antmicro/thunderbolt-gpu-adapter/assets/previews/layer5.png

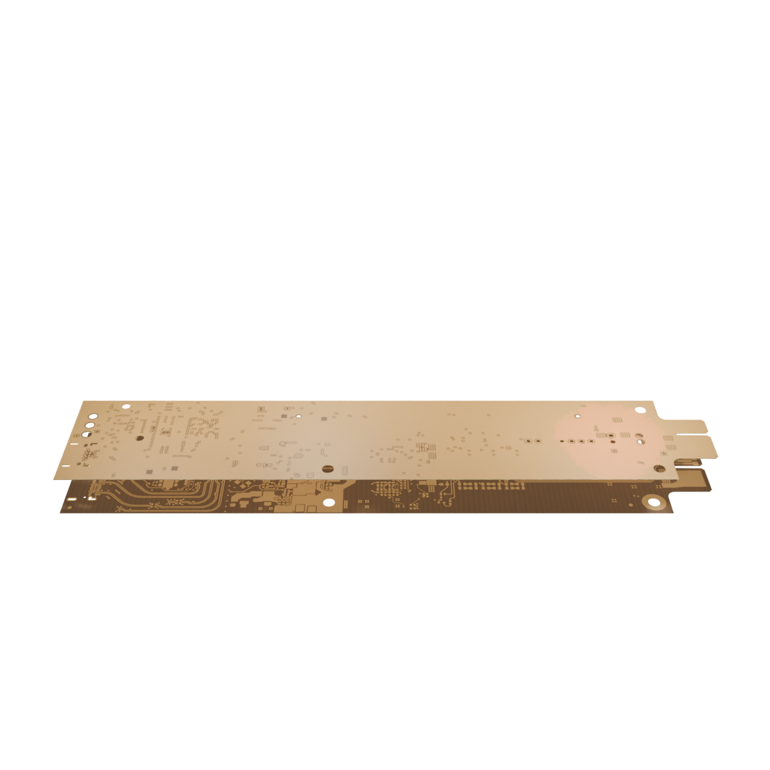
assets/previews/layer5.png
