antmicro/thunderbolt-gpu-adapter/assets/previews/leftB.png

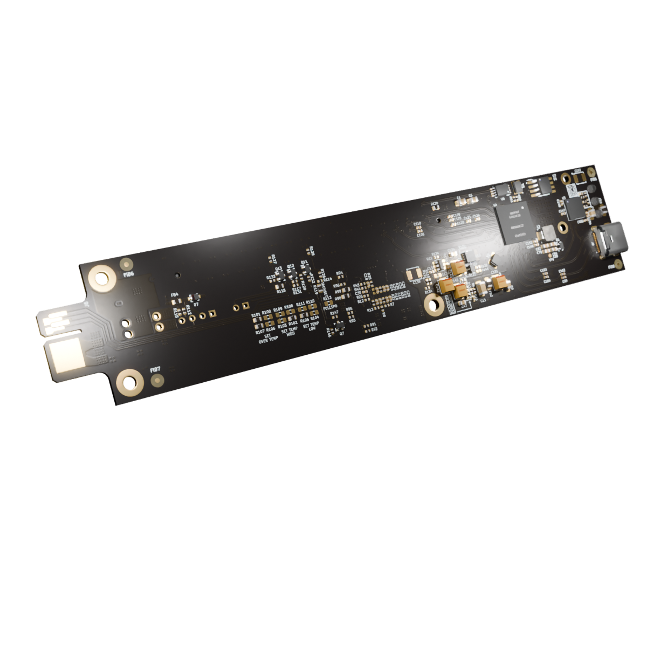
assets/previews/leftB.png
