antmicro/thunderbolt-gpu-adapter/assets/previews/leftT.png

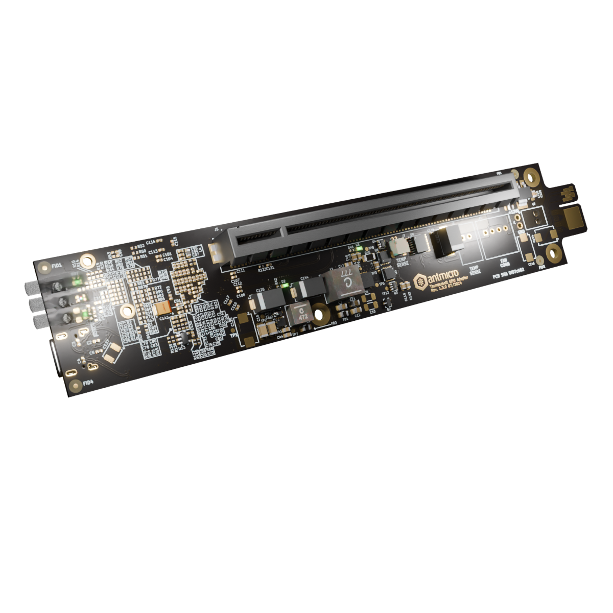
assets/previews/leftT.png
