antmicro/thunderbolt-gpu-adapter/assets/previews/orthoB.png

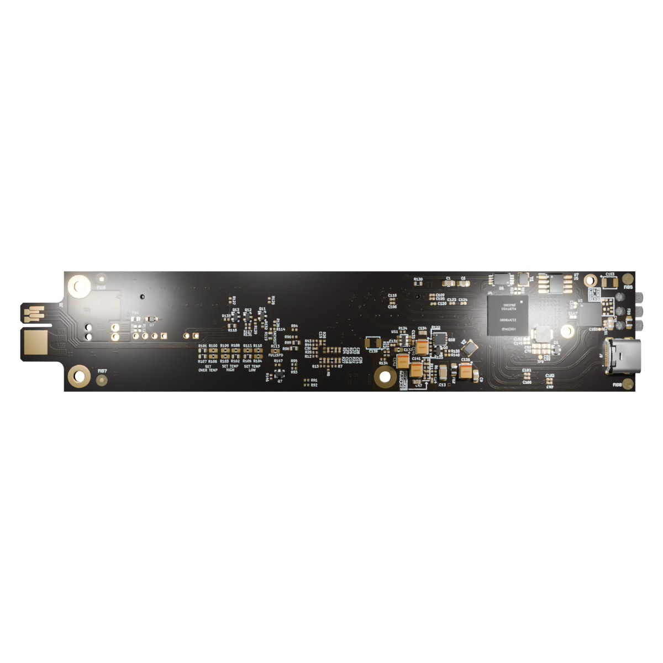
assets/previews/orthoB.png
