antmicro/thunderbolt-gpu-adapter/assets/previews/photoB.png

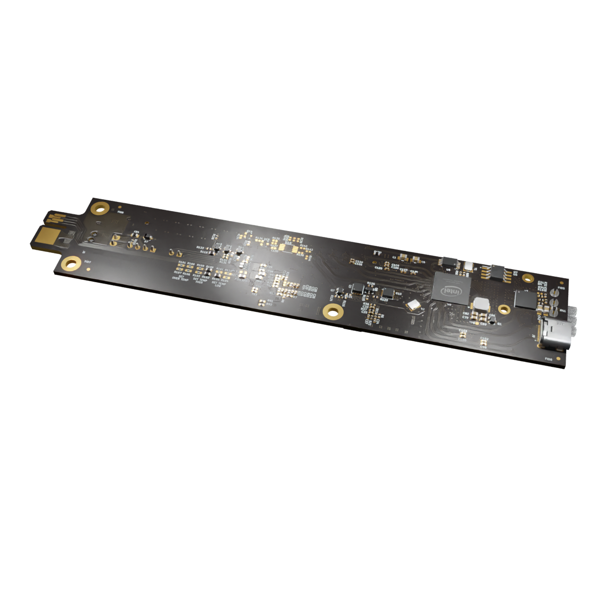
assets/previews/photoB.png
