antmicro/thunderbolt-gpu-adapter/assets/previews/rightB.png

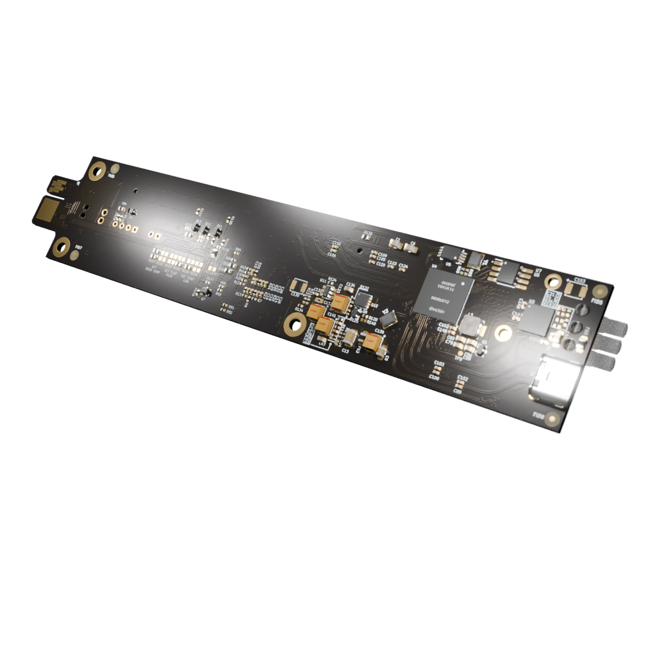
assets/previews/rightB.png
