antmicro/thunderbolt-gpu-adapter/doc/thunderbolt-gpu-adapter.pdf

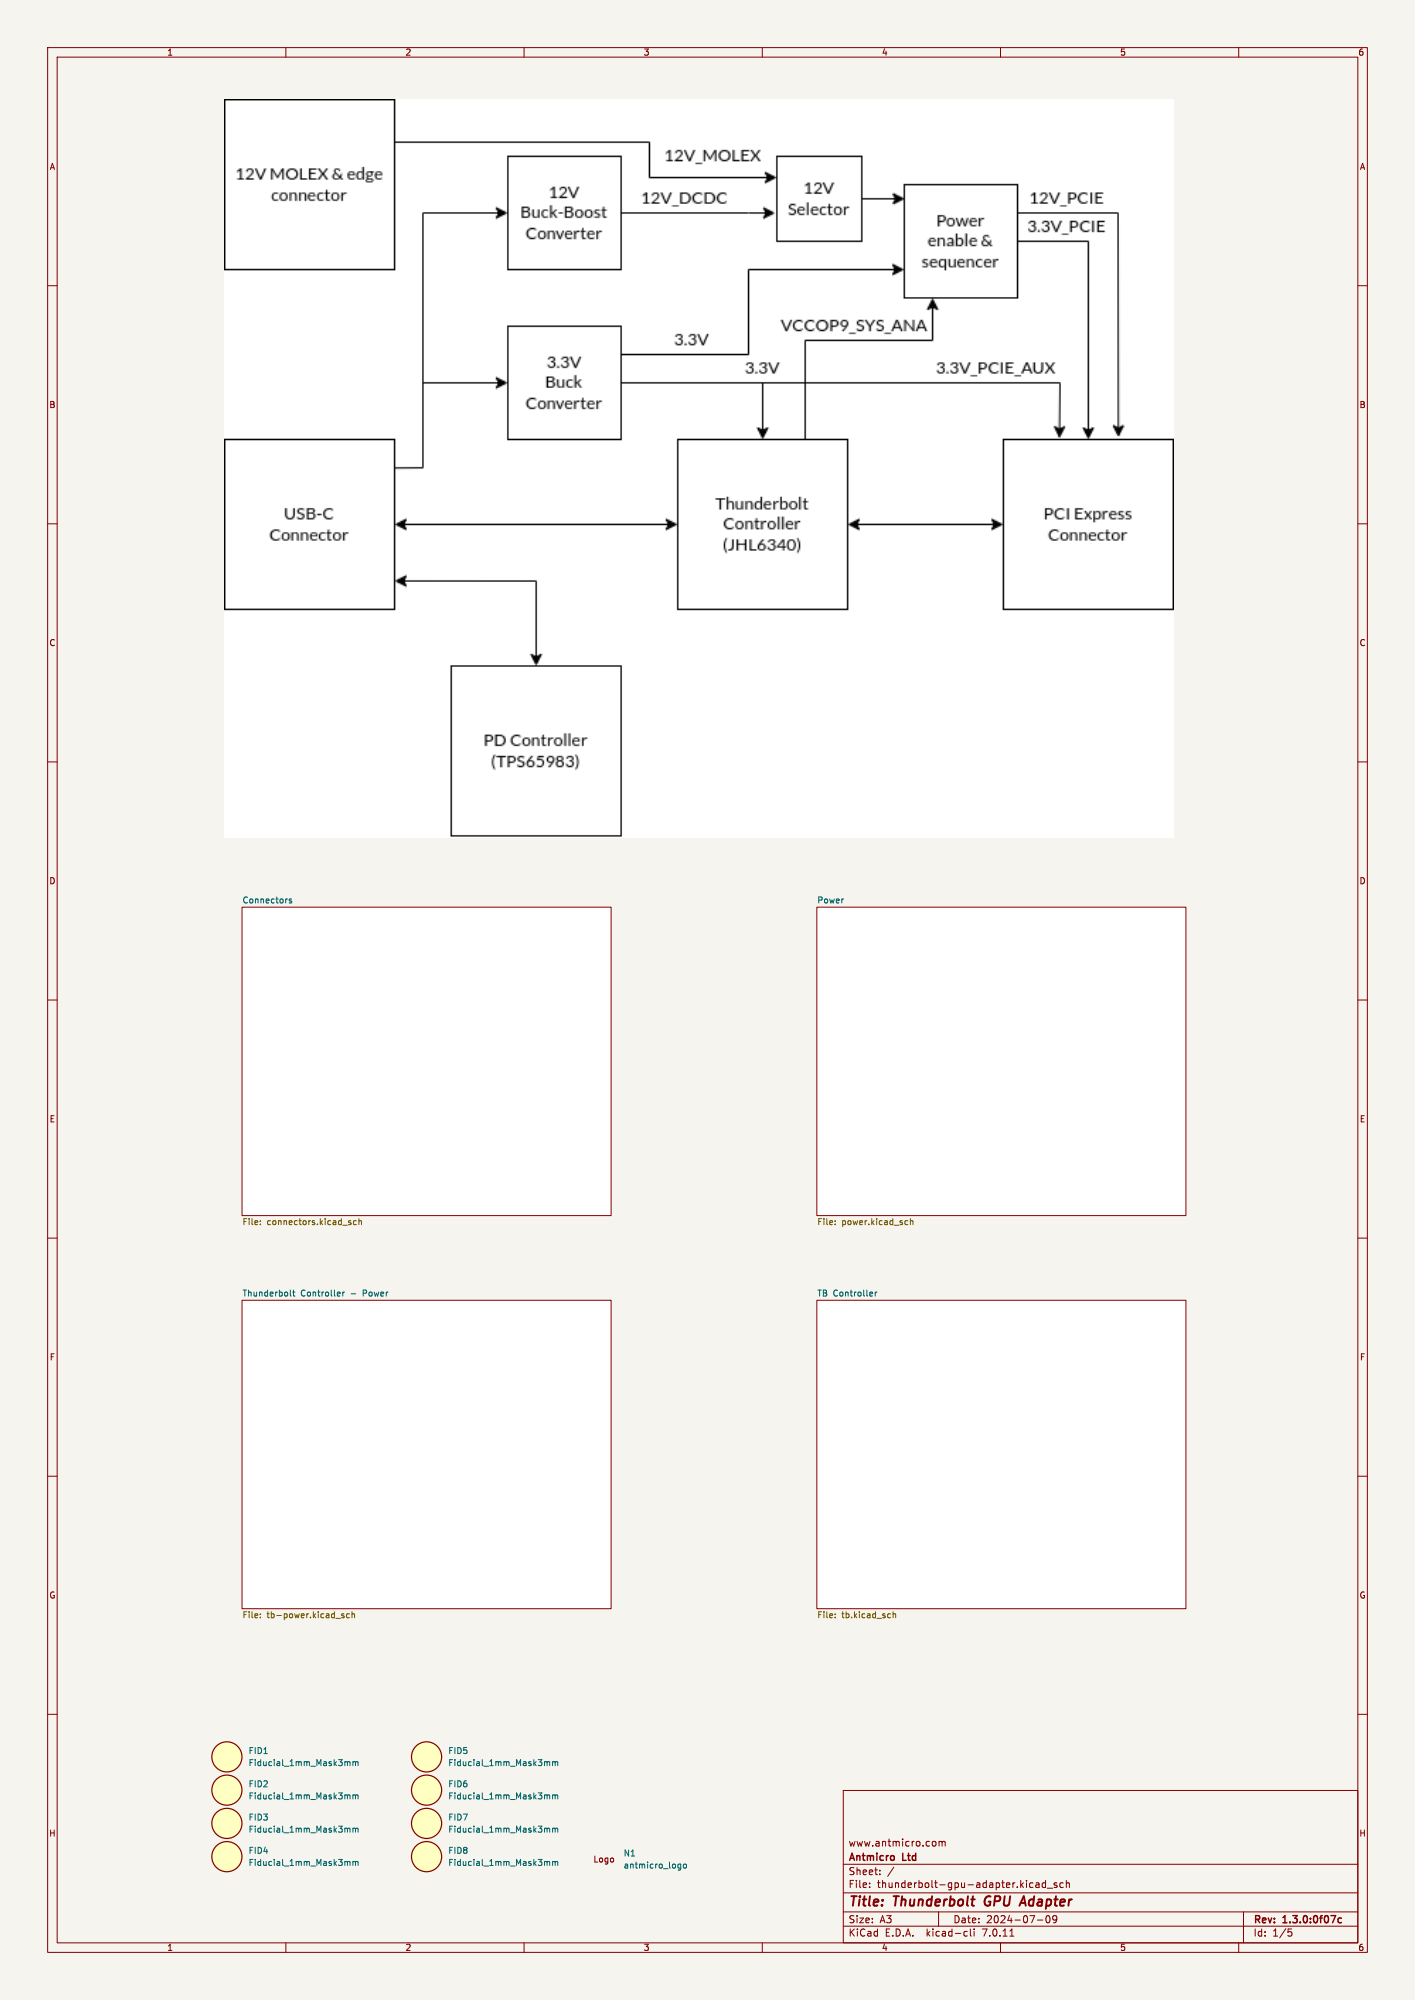
[picture p10: page 1]

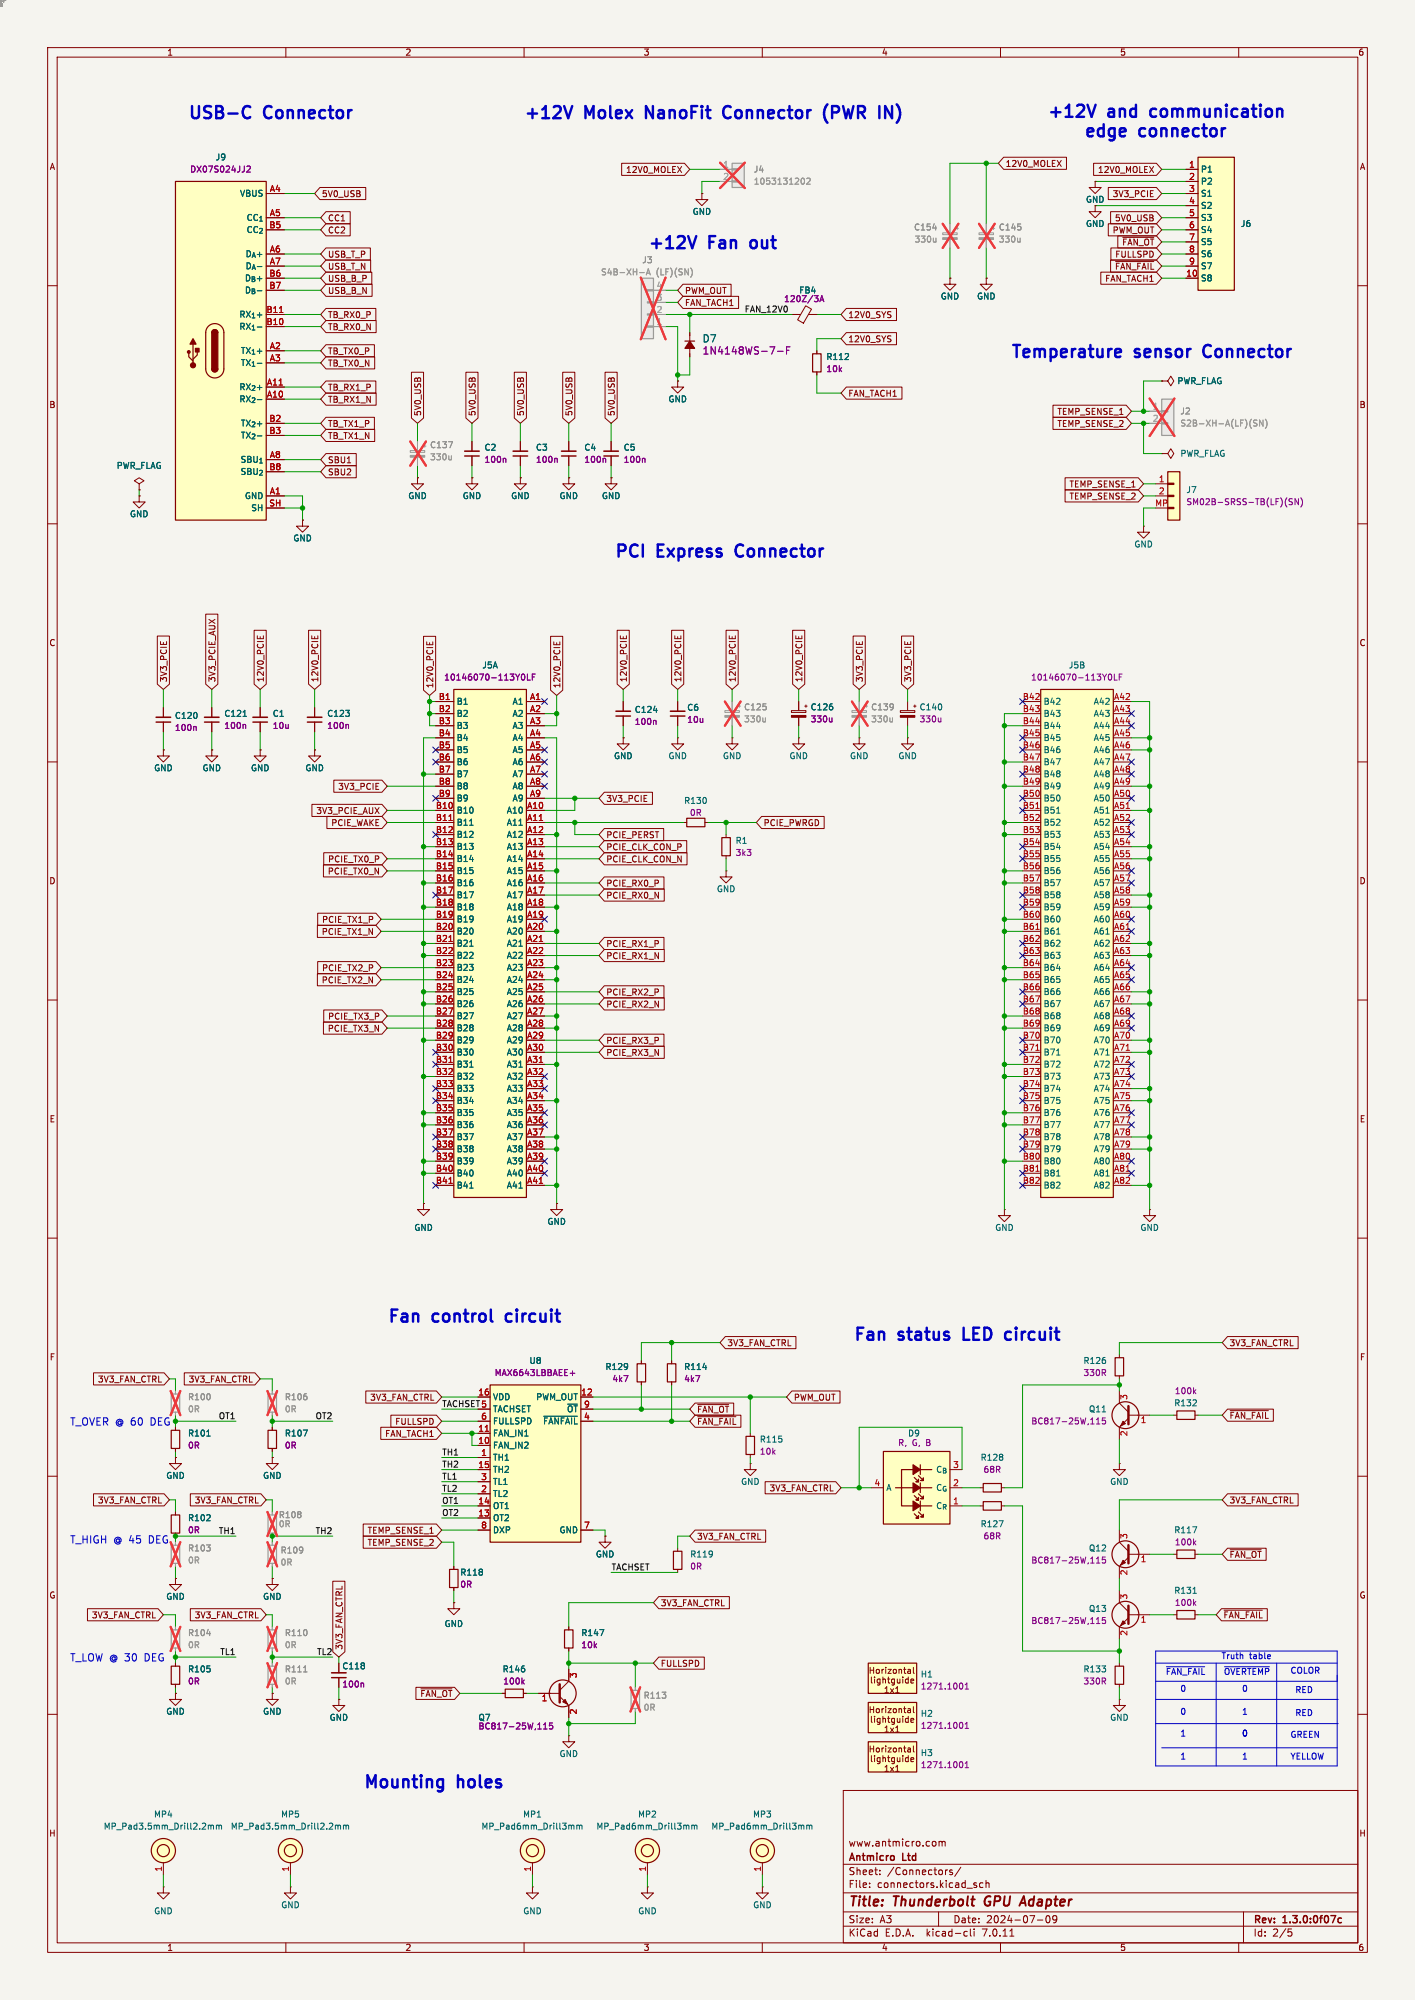
[picture p11: page 2]

+12V Molex NanoFit Connector (PWR IN)

J7SM02B-SRSS-TB(LF)(SN)

Truth table Fan status LED circuit

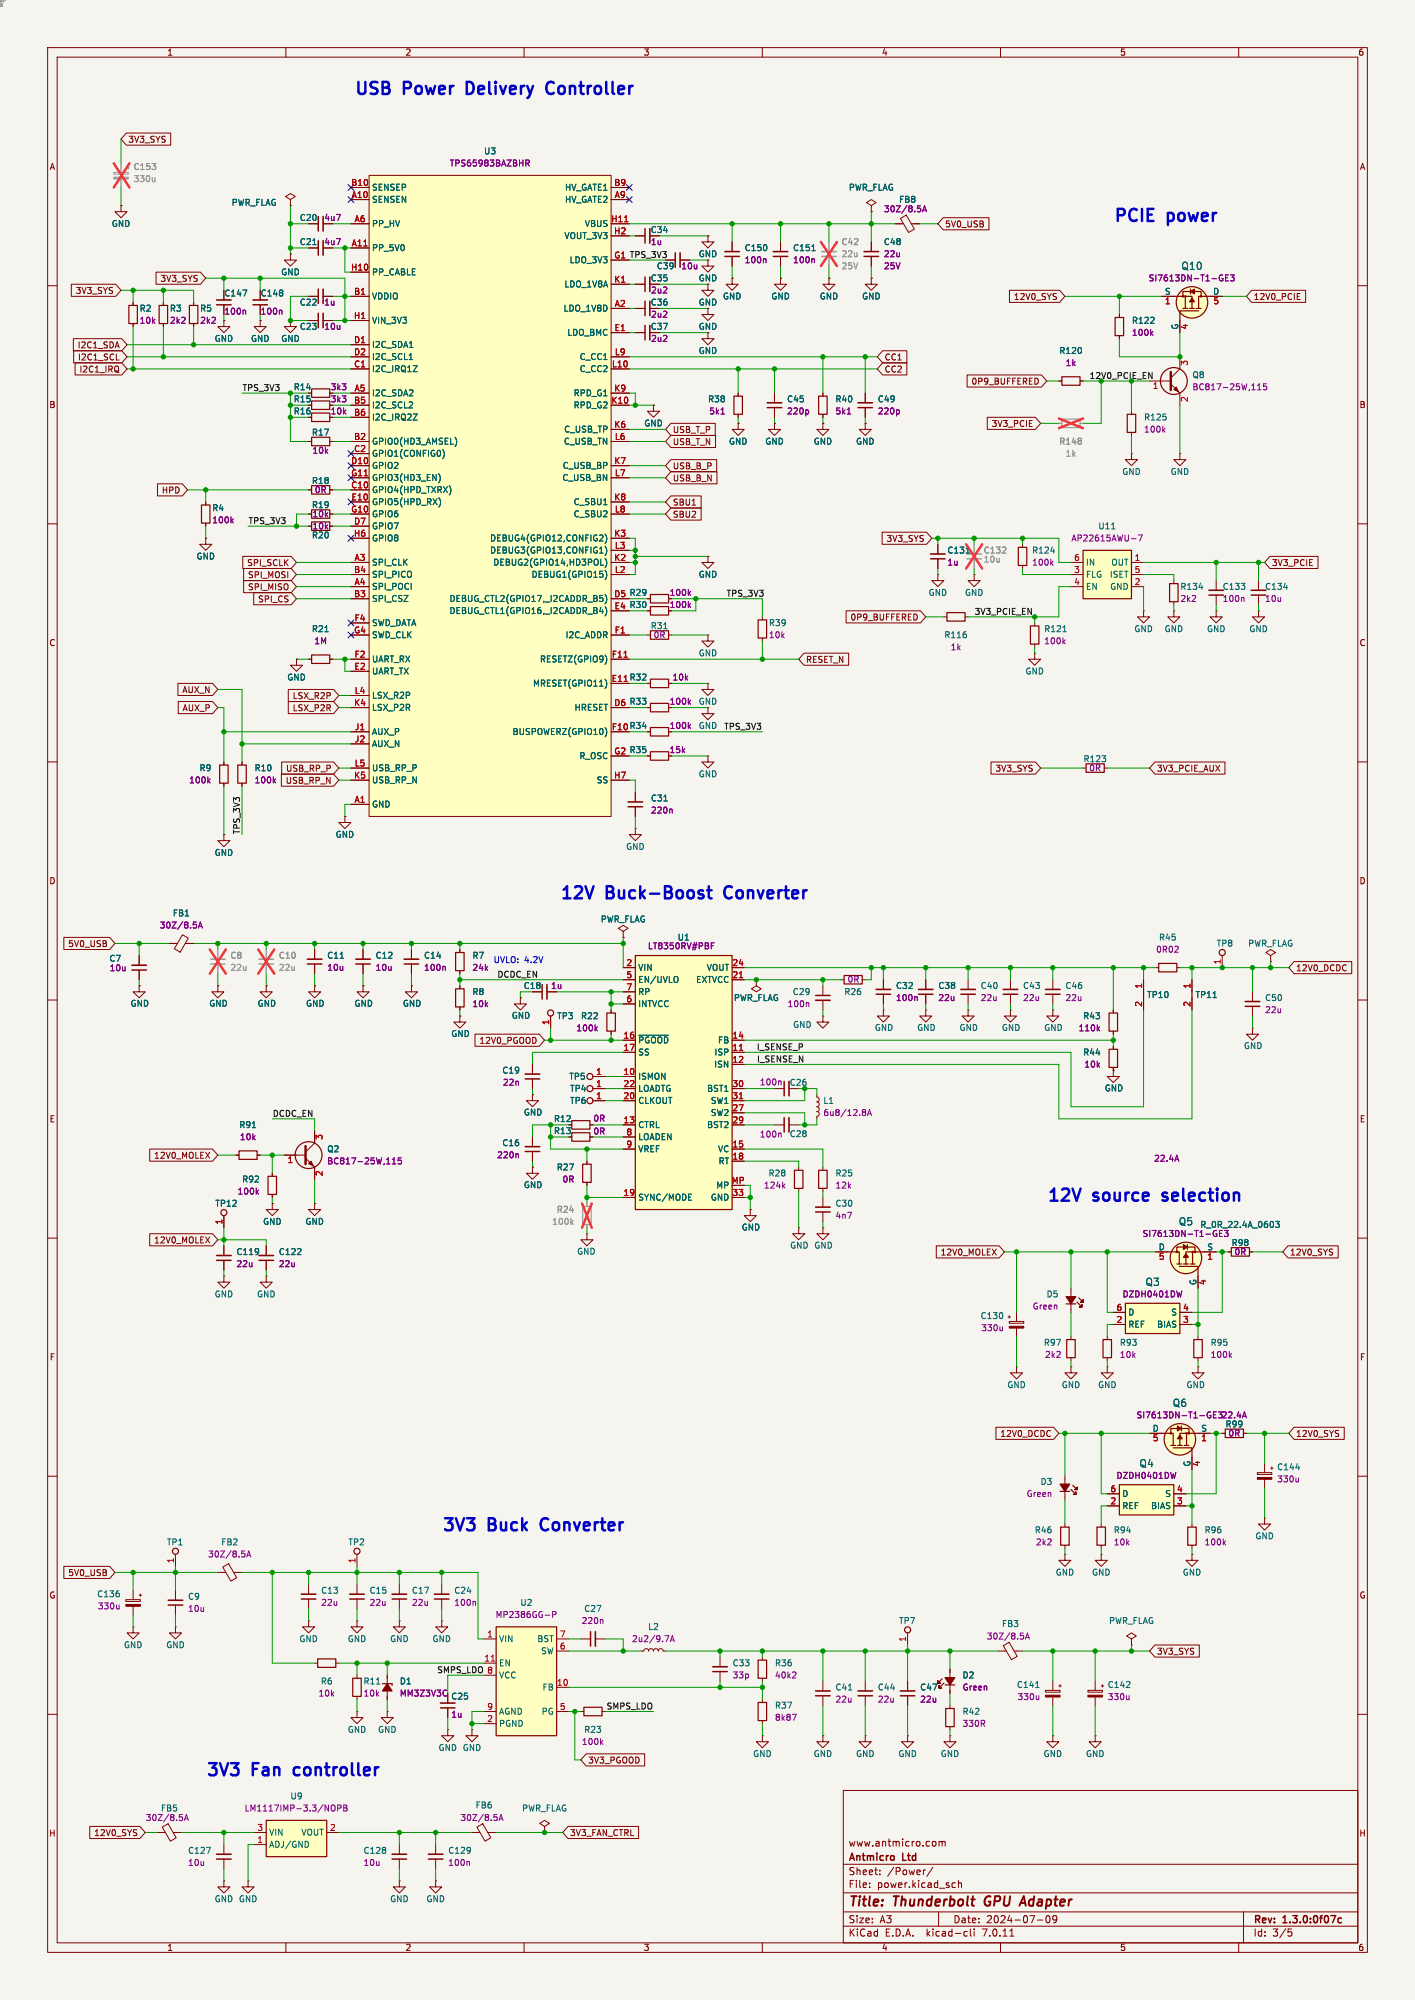
[picture p12: page 3]

USB Power Delivery Controller

OUT 1 GND 2 FLG 3 EN 4

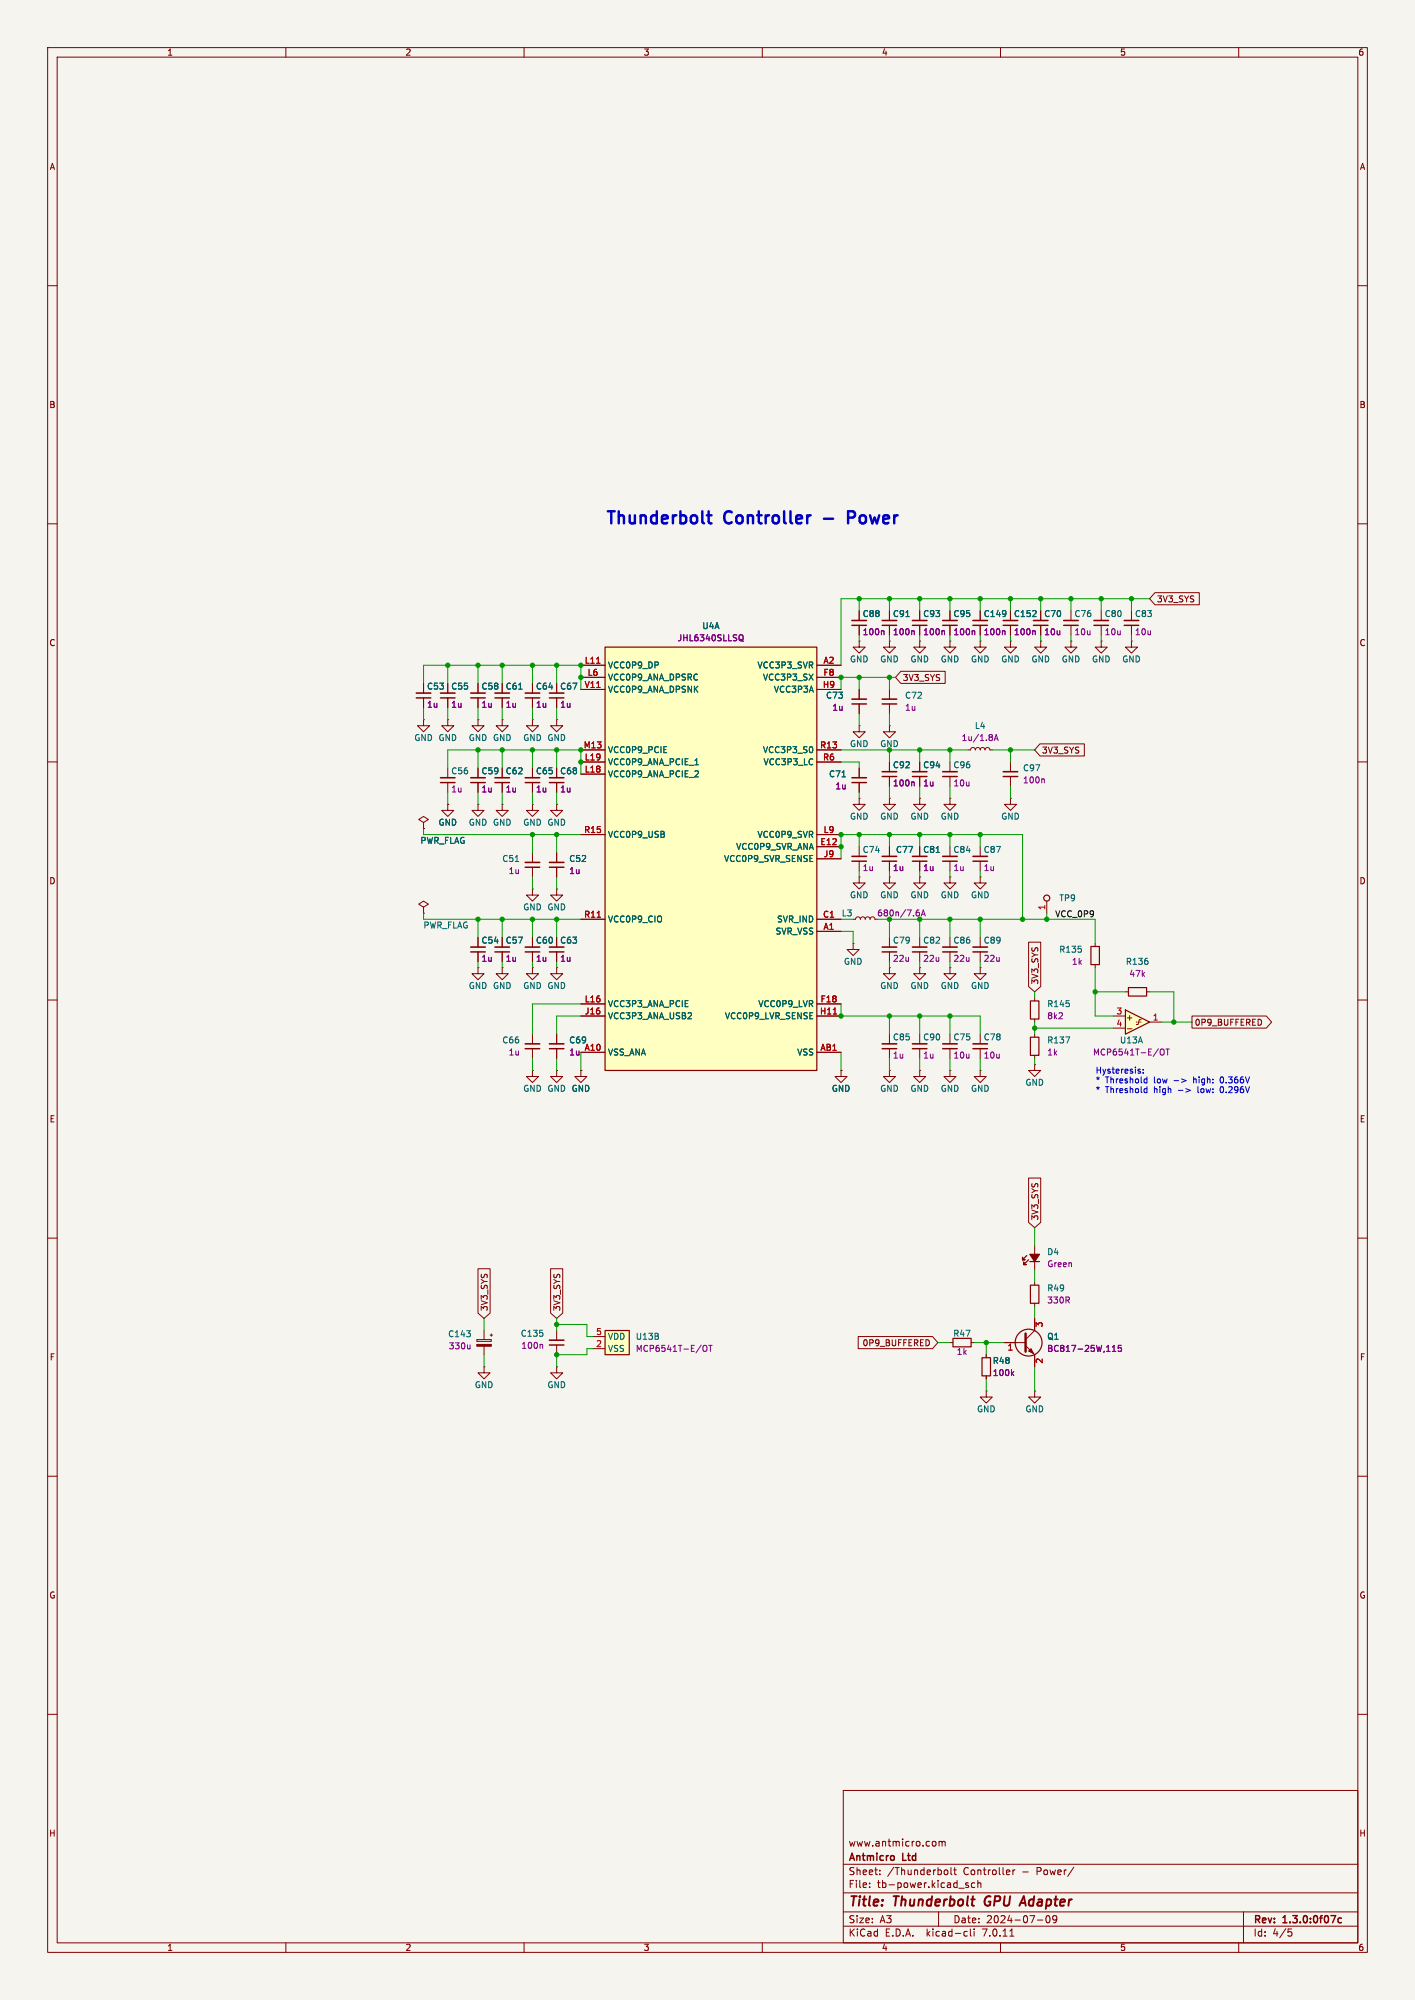
[picture p13: page 4]

1u GND GND GND GND

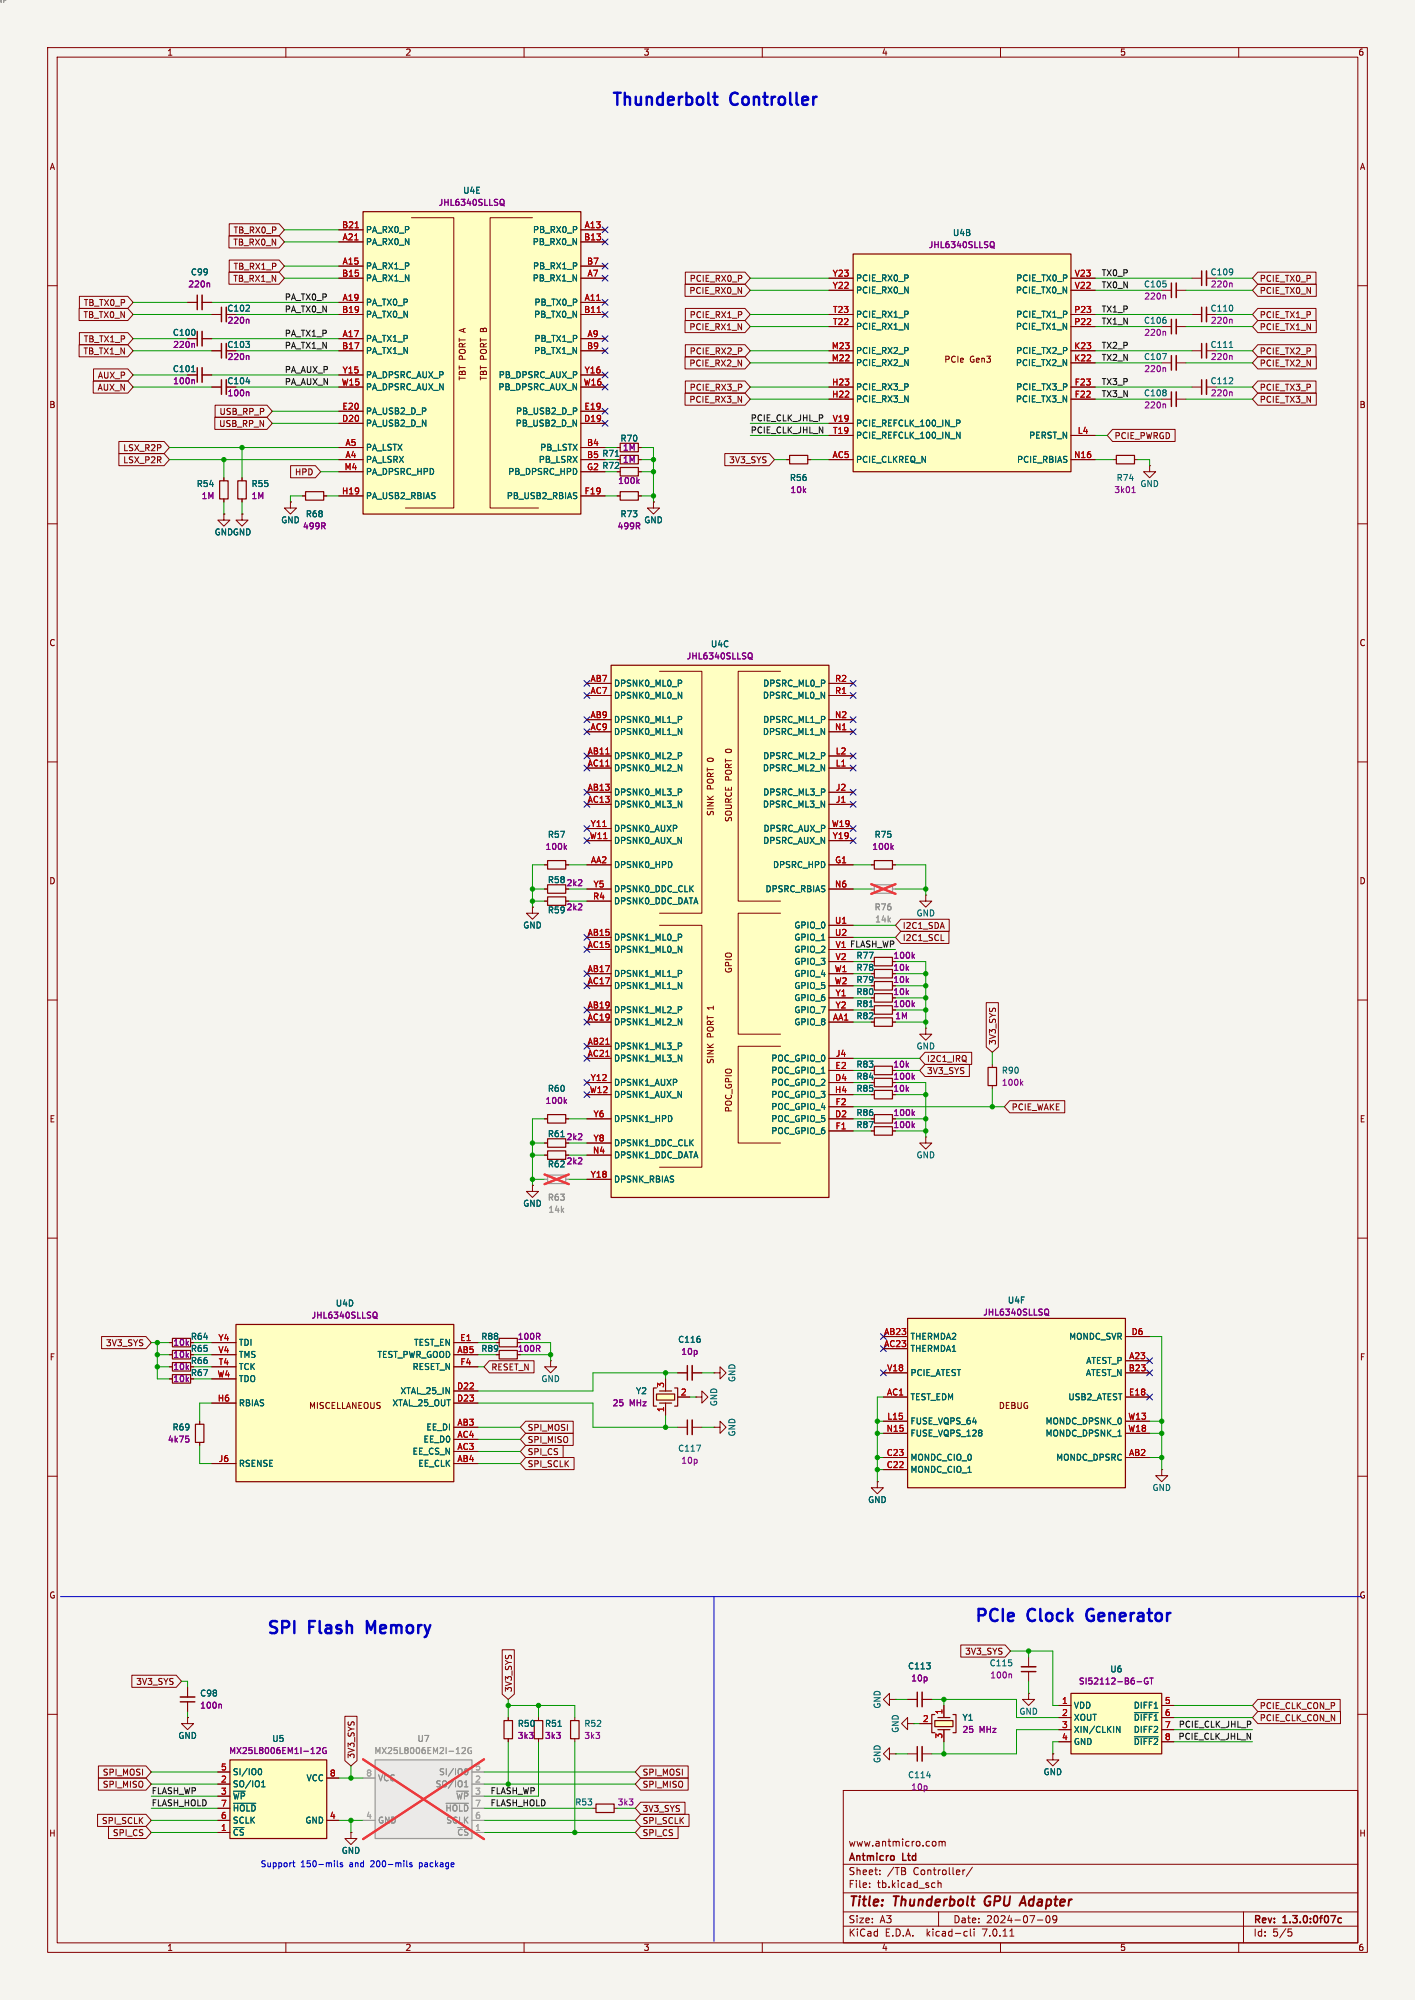
[picture p14: page 5]

EE_DI AB3 EE_CLK AB4 TEST_PWR_GOOD AB5 EE_CS_N AC3 EE_D0 AC4 XTAL_25_IN D22 XTAL_25_OUT D23 TEST_EN E1 RESET_N F4 RBIAS H6 RSENSE J6 TCK T4 TMS V4 TDO W4 TDI Y4 R67 10k R66 10k R65 10k R64 10k R69

3 U6 SI52112-B6-GT VDD 1 XOUT 2 XIN/CLKIN 3 GND 4 DIFF1 5 ~{DIFF1}6 DIFF2 7 ~{DIFF2}8 R50
