antmicro/thunderbolt-gpu-adapter/(commit log)

2023-06-01 Created fork of repository antmicro-thunderbolt-adapter-hw at commit c74e95fb7143df2f67f246c45c6252ce13668db7
    [connectors.kicad_sch, power.kicad_sch, tb-power.kicad_sch, tb.kicad_sch, thunderbolt-adapter.kicad_sch]
2023-06-01 Created mechanical mockup
    [connectors.kicad_sch, thunderbolt-adapter.kicad_sch]
2023-06-02 Updated mechanical mockup
    [connectors.kicad_sch, thunderbolt-adapter.kicad_pcb, thunderbolt-adapter.kicad_sch]
2023-06-16 Sch - connected power connectors and USB C
    [connectors.kicad_sch, thunderbolt-adapter.kicad_pcb, thunderbolt-adapter.kicad_sch]
2023-06-16 Sch connected PCIex16 connector
    [connectors.kicad_sch, thunderbolt-adapter.kicad_sch]
2023-06-19 Added connectors for fan and temperature sensors
    [connectors.kicad_sch, thunderbolt-adapter.kicad_sch]
2023-06-19 Sch - Added control circuit for fan #45132
    [connectors.kicad_sch, thunderbolt-adapter.kicad_sch]
2023-06-19 PCB - placed power planes
    [connectors.kicad_sch, thunderbolt-adapter.kicad_sch]
2023-06-19 PCB - working on reuse of PCB layout
2023-06-20 PCB - copied layout from thunderbolt research PCB
2023-06-20 PCB - routed differential signals of PCIe
2023-06-20 PCB - done most of the signals related to PCIe
2023-06-20 PCB - routed SPI flash
2023-06-20 PCB - placed PD controller, working on connecting signals
2023-06-20 PCB - routed most of the signals coming from PD controller and some thunderbolts tracks
2023-06-20 SCH&PCB - replaced USB C connector, routing in progress
    [connectors.kicad_sch, thunderbolt-adapter.kicad_sch]
2023-06-21 PCB - working on USB C connections
2023-06-21 PCB work in progress
    [connectors.kicad_sch, thunderbolt-adapter.kicad_sch]
2023-07-14 Added poweredge connector, updated connector for temperature sensor and fan
    [connectors.kicad_sch, thunderbolt-adapter.kicad_sch]
2023-07-17 Added connections to edge connector and updated fan controller configuration
    [connectors.kicad_sch, power.kicad_sch, thunderbolt-adapter.kicad_sch]
2023-07-17 Placed fiducials and mounting holes #46047
    [connectors.kicad_sch, thunderbolt-adapter.kicad_sch]
2023-07-17 PCB - routed fan control section
    [connectors.kicad_sch, thunderbolt-adapter.kicad_sch]
2023-07-17 PCB - worked on power planes and connections for power converters
    [connectors.kicad_sch]
2023-07-17 PCB - worked on USB C connections
2023-07-18 PCB - lenght matched USB C signals
2023-07-18 PCB tuned lenght of the PCIe tracks
2023-07-18 PCB rerouted SPI connections
2023-07-18 PCB - placed designators on F.Silkscreen
    [connectors.kicad_sch]
2023-07-19 PCB fixed polygons
2023-07-19 PCB rerouted accidentally rounded tracks, repositioned LEDs, fixed unconnected nets
2023-07-19 PCB rerouted USB C connections
2023-07-19 PCB routed LEDs
2023-07-19 PCB corrected LEDs positions to avoid colisions
2023-07-19 PCB repositioned elements on B.Silkscreen
2023-07-20 PCB tuned lenght of the thunderbolt lines
2023-07-20 PCB tuned lenght of the tUSB 2.0 lines
2023-07-20 PCB working on DRC errors
2023-07-20 PCB fixed DRC errors
2023-07-20 PCB fixed DRC warning
2023-07-20 PCB - final touches, board staged for review
2023-07-24 Corrected paste openings on the edge connector
    [connectors.kicad_sch, thunderbolt-adapter.kicad_sch]
2023-07-24 PCB added gnd vias near USB 2.0 signals
2023-07-24 PCB rerouted kelvin probe tracks
2023-07-24 PCB fixed capacitors references in PCIe lines
2023-07-24 PCB Cleaned up F.Fab and B.Fab layers
2023-07-24 PCB equalized and rerouted PCIe lines
2023-07-24 PCB USB 2.0 fixed splitted ref plane, added GND ref plane on IN3.Cu
2023-07-24 PCB PCIe repositioned meanders closer to the causes of the lenght mismatches
2023-07-24 PCB reworked USB 4.0 lines - ref planes under cap, fixed tracks, moved meanders closer to the causes of lenght mismatch
2023-07-24 PCB fixed all DRC errors and warnings
2023-07-25 PCB correcting thunderbolt lines lenght matching
2023-07-25 PCB fixed some traces, added decoupling capacitor, lenght tuned USB 2.0
    [connectors.kicad_sch, thunderbolt-adapter.kicad_sch]
2023-09-20 #49443 Bump rev to 1.1.0
    [connectors.kicad_sch, power.kicad_sch, tb-power.kicad_sch, tb.kicad_sch, thunderbolt-adapter.kicad_sch]
2023-09-20 [#49443] Add Fan_fail LED, Fix TLow config res
    [connectors.kicad_sch, thunderbolt-adapter.kicad_sch]
2023-09-21 [#49443] Change Fan header to 4 pin, remove Fan switching MOSFET
    [connectors.kicad_sch, thunderbolt-adapter.kicad_sch]
2023-09-21 Added pull down to floading PWM_OUT
    [connectors.kicad_sch, thunderbolt-adapter.kicad_sch]
2023-09-21 Removed unused barell jack connector
    [connectors.kicad_sch, thunderbolt-adapter.kicad_sch]
2023-09-21 Replaced USB C connector
    [connectors.kicad_sch, thunderbolt-adapter.kicad_sch]
2023-09-22 Replaced fan connector, temp sens conn, replaced polarity on molex
    [connectors.kicad_sch, thunderbolt-adapter.kicad_sch]
2023-09-22 Updated power diagram
    [connectors.kicad_sch, power.kicad_sch, thunderbolt-adapter.kicad_sch]
2023-09-22 Added switches for toggling PCIe power
    [connectors.kicad_sch, power.kicad_sch, tb-power.kicad_sch]
2023-09-25 Working on USB C HS routing
    [connectors.kicad_sch, power.kicad_sch, thunderbolt-adapter.kicad_sch]
2023-09-26 Replaced edge connector
    [connectors.kicad_sch, thunderbolt-adapter.kicad_sch]
2023-09-26 WIP Working in PCIE power
    [connectors.kicad_sch]
2023-09-26 WIP Reworked PCIE power planes
2023-09-26 Routed 3V3_PCIE
    [connectors.kicad_sch, thunderbolt-adapter.kicad_sch]
2023-09-26 Rerouted power planes for powering PCIE
2023-09-26 Placed and routed components for switching power for PCIE
2023-09-26 Added power plane for 12V0_MOLEX
2023-09-26 Placed lightpipes
    [connectors.kicad_sch]
2023-09-27 WIP working on USB C routing
    [thunderbolt-adapter.kicad_sch]
2023-09-27 Placed LEDs in the desired spots
2023-09-27 Added logic circuit for controlling RGB led
    [connectors.kicad_sch, thunderbolt-adapter.kicad_sch]
2023-09-27 Redesigned power circuitry for the fan controller
    [power.kicad_sch, thunderbolt-adapter.kicad_sch]
2023-09-28 Routed unconnected nets
    [connectors.kicad_sch]
2023-09-28 Improved PCIE power section
2023-11-15 Resolve DRC
    [connectors.kicad_sch]
2023-11-15 Added pin on edge connector for safe powering the device
    [connectors.kicad_sch]
2023-11-15 Added signals for edge connector
    [connectors.kicad_sch]
2023-11-15 Added optional power sequencer for PCIe device
    [connectors.kicad_sch, power.kicad_sch, thunderbolt-adapter.kicad_sch]
2023-11-15 Fixed titles on silkscreen
2023-11-15 Deleted remains on silkscreen
2023-11-15 Corrected designators outside the board
2023-11-15 Added GND return vias near USB C HS tracks
2023-11-15 Updated edge connector
2023-11-15 [#49762] Add keepout area on edge connector
2023-11-15 [#49762] Flip the edge connector
    [connectors.kicad_sch, power.kicad_sch]
2023-11-15 [#49762] Fix power planes and solve drc
2023-11-15 [#49762] Fix missing 3D models
    [connectors.kicad_sch, power.kicad_sch, tb-power.kicad_sch, thunderbolt-adapter.kicad_sch]
2023-11-15 Tried editing edge connector to made board pass validation on ec
2023-11-15 Fixed board edge cuts
2023-11-15 Update edge connector's Edge.Cuts
2023-11-15 Remove tracks with length 0mm or close to 0mm
2023-11-15 Add PCB SHA on silkscreen
2023-11-15 [#51365] Fix wrong Silkscreen markings on the J4 Molex NanoFit conn
2023-11-15 Bump rev to 1.1.1
    [connectors.kicad_sch, power.kicad_sch, tb-power.kicad_sch, tb.kicad_sch, thunderbolt-adapter.kicad_sch]
2023-11-15 Run kmake loclib
    [connectors.kicad_sch, power.kicad_sch, tb-power.kicad_sch, tb.kicad_sch, thunderbolt-adapter.kicad_sch]
2023-11-15 Rename project to thunderbolt-gpu-adapter
    Fix Amphenol 10146070-113Y0LF footprint
    Add missing 3D models, update selected footprints
    [connectors.kicad_sch, power.kicad_sch, tb-power.kicad_sch, tb.kicad_sch, thunderbolt-adapter.kicad_sch, thunderbolt-gpu-adapter.kicad_sch]
2023-11-15 Add PDF schematic
2023-11-15 51413 Add OHP assets
    [stackup.csv]
2023-11-21 Update PCIe power switching circuit (SCH)
    [connectors.kicad_sch, power.kicad_sch, tb-power.kicad_sch, thunderbolt-gpu-adapter.kicad_sch]
2023-11-21 Fix PCIe power switch - layout, bump revision to 1.1.2
    [connectors.kicad_sch, power.kicad_sch, tb-power.kicad_sch, tb.kicad_sch, thunderbolt-gpu-adapter.kicad_sch]
2023-11-21 Add forcing FULLSPD from FAN_OT inverter circuit to schematic
    [connectors.kicad_sch, thunderbolt-gpu-adapter.kicad_sch]
2023-11-22 Add forcing FULLSPEED from FANOUT circuit to PCB
2023-11-22 [#51657][Schematic] Fix RGB LED logic circuit
    [connectors.kicad_sch, thunderbolt-gpu-adapter.kicad_sch]
2023-11-22 [#51657][Schematic] Fix label names DRCs
    [connectors.kicad_sch, power.kicad_sch, tb-power.kicad_sch, tb.kicad_sch, thunderbolt-gpu-adapter.kicad_sch]
2023-11-22 [#51657][Schematic] Fix wrong nets on the edge connector pins
    [connectors.kicad_sch]
2023-11-22 [#51657][PCB] Route fixed lanes to RGB LED
2023-11-23 Clean up and revision bump
    [connectors.kicad_sch, power.kicad_sch, tb-power.kicad_sch, tb.kicad_sch, thunderbolt-gpu-adapter.kicad_sch]
2023-11-24 Fix U13 Vref divider
    [tb-power.kicad_sch]
2023-11-24 Fix OT and Fan fail pull up resistors
    [connectors.kicad_sch, thunderbolt-gpu-adapter.kicad_sch]
2023-11-24 Add TODOs to the schematic
    [connectors.kicad_sch]
2023-11-24 Rerun kmake loclib
    [connectors.kicad_sch, power.kicad_sch, tb-power.kicad_sch, tb.kicad_sch, thunderbolt-gpu-adapter.kicad_sch]
2023-11-24 Import changes to the PCB
2023-11-24 Change T_OVER to 60 deg
    [connectors.kicad_sch, power.kicad_sch, tb-power.kicad_sch, tb.kicad_sch, thunderbolt-gpu-adapter.kicad_sch]
2023-11-24 Change T_HIGH to 45 deg
    [connectors.kicad_sch]
2023-12-01 Fix ERC errors on schematic:
    - Fix first batch of GND ERC
    - Fix second batch of GND ERC
    - Fix ERC of 0R_0603
    - Fix erc BC817-25W
    - Fix erc 220n_0402
    - Fix erc PCIe_x16_10146070-113Y0LF-vertical
    - Fix erc 100n_0402
    - Fix erc 10u_0805_35V
    - Correct BC817-25W_1
    - Correct erc R_98R_0402_1
    - Correct 10K_0402
    - Correct 22u/16V
    - Correct 100k
    - Correct 499R
    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
    [connectors.kicad_sch, power.kicad_sch, tb-power.kicad_sch, tb.kicad_sch, thunderbolt-gpu-adapter.kicad_sch]
2023-12-01 Added JST SH fan and temp sensor connectors to sch
    [connectors.kicad_sch, thunderbolt-gpu-adapter.kicad_sch]
2023-12-01 Added connectors to PCB and cleaned DRC
    [connectors.kicad_sch, thunderbolt-gpu-adapter.kicad_sch]
2023-12-01 Add missing 10k pullup on Fan Tacho
    [connectors.kicad_sch, thunderbolt-gpu-adapter.kicad_sch]
2023-12-01 Fix 12V Power connector polarization
    [connectors.kicad_sch]
2024-01-15 SCH Added filtration to USB C port
    [connectors.kicad_sch, thunderbolt-gpu-adapter.kicad_sch]
2024-01-15 Add filtration to PD controller
    [connectors.kicad_sch, power.kicad_sch, thunderbolt-gpu-adapter.kicad_sch]
2024-01-15 Improved power filtration for TB controller
    [power.kicad_sch, tb-power.kicad_sch, thunderbolt-gpu-adapter.kicad_sch]
2024-01-15 WIP Working on layout of the PCIe power
    [connectors.kicad_sch, power.kicad_sch, thunderbolt-gpu-adapter.kicad_sch]
2024-01-15 Added filtration for 3V3_SYS, 12V0_SYS, 3V3_PCIE, 12V0_PCIE
    [power.kicad_sch, thunderbolt-gpu-adapter.kicad_sch]
2024-01-15 Added DNP capacitors in empty spaces
    [connectors.kicad_sch, power.kicad_sch, thunderbolt-gpu-adapter.kicad_sch]
2024-01-15 Removed optional power sequencing
    [power.kicad_sch, thunderbolt-gpu-adapter.kicad_sch]
2024-01-15 Add filtration to 12V0_MOLEX
    [power.kicad_sch, thunderbolt-gpu-adapter.kicad_sch]
2024-01-15 Fix DRC
    [power.kicad_sch]
2024-01-15 Added capacitors of 12V0_MOLEX as DNP
    [power.kicad_sch, thunderbolt-gpu-adapter.kicad_sch]
2024-01-15 [#53193] Remove J1
    [connectors.kicad_sch, power.kicad_sch, thunderbolt-gpu-adapter.kicad_sch]
2024-01-15 [#53193] Move C145 C154
    [connectors.kicad_sch, power.kicad_sch, thunderbolt-gpu-adapter.kicad_sch]
2024-01-15 [#53193] Resolve mechanical collisions
    [connectors.kicad_sch, power.kicad_sch, tb-power.kicad_sch, tb.kicad_sch, thunderbolt-gpu-adapter.kicad_sch]
2024-01-15 [#53193] Move C136 on schematic
    [connectors.kicad_sch, power.kicad_sch, thunderbolt-gpu-adapter.kicad_sch]
2024-01-15 Bump revision to 1.2.1
    [connectors.kicad_sch, power.kicad_sch, tb-power.kicad_sch, tb.kicad_sch, thunderbolt-gpu-adapter.kicad_sch]
2024-01-15 [#53193] Move bulk capacitors
    [power.kicad_sch, tb-power.kicad_sch, thunderbolt-gpu-adapter.kicad_sch]
2024-01-15 Fix DRC on power planes
2024-01-15 Fix date and rev
    [connectors.kicad_sch, power.kicad_sch, tb-power.kicad_sch, tb.kicad_sch, thunderbolt-gpu-adapter.kicad_sch]
2024-01-15 Reposition capacitors near bottom edge of the PCB to avoid collisions with casing
2024-01-15 Mark capacitors and connectors as DNP
    [connectors.kicad_sch, power.kicad_sch]
2024-02-26 Migration to kicad7
    [connectors.kicad_sch, power.kicad_sch, tb-power.kicad_sch, tb.kicad_sch, thunderbolt-gpu-adapter.kicad_sch]
2024-04-18 Repositioned capacitors near C44
2024-04-18 Fix 3v3 Buck converter-U2 layout
2024-04-18 Solve schematic parity warrnings
2024-04-18 Adjust power planes
2024-04-19 Remove glitched trace
2024-04-22 Bump revision to 1.2.2
    [connectors.kicad_sch, power.kicad_sch, tb-power.kicad_sch, tb.kicad_sch, thunderbolt-gpu-adapter.kicad_sch]
2024-05-28 Remove footprint keepout from the edge connector footprint
2024-06-07 [#58279] Update PDF schematic
2024-07-01 [#61660] Update capacitors on the schematic
2024-07-01 [#61660] Update diodes on the schematic
2024-07-01 [#61660] Update ferrite beads on the schematic
2024-07-01 [#61660] Update fiducials on the schematic
2024-07-01 [#61660] Update connectors on the schematic
2024-07-01 [#61660] Update transistors on the schematic
2024-07-02 [#61660] Allign schematic
2024-07-02 [#61660] Update footprints on PCB
2024-07-08 [#61660] Minor schematic changes
2024-07-09 [#61660] Update rev on PCB
2024-07-09 [#61660] Allign GND symbols in power.kicad_sch
2025-02-04 Save in KiCad 8
